PaulMargot/Casque-velo/Rapports seances Margot/Seance3/compte_rendu_seance3.odt

Compte rendu séance 3 :

Durant cette 3ème séance j'ai fait la partie programmation en rapport avec la photorésistance et le freinage. C'est-à-dire l'allumage du phare (LED verte) et du feu (LED rouge) lorsque la luminosité extérieure est trop faible, afin de rendre visible la route et l'utilisateur, et celui du feu lorsqu'on freine.

Ainsi j'ai complété mon programme « clignotants » en créant « LEDs_casque », regroupant les fonctionnalités liées à l'eclairage du casque, c'est-à-dire les clignotants, le phare et le feu.

L'allumage du feu se divise en deux parties. Une première partie est liée à la luminosité ambiante (''// Feu luminosite'' dans le programme) et une autre à l'accélération (''// Feu accelerometre''), qui détecte lorsque l'on freine afin d'allumer avec plus d'intensité notre feu.

Cette différence d'intensité sera normalement visible par l'allumage de plus nombreuses LEDs lors du freinage, suivant le même modèle que les feux de voiture.

De telle manière :

Nuit/Jour + freinage :

Nuit :

: LED éteinte

: LED allumée

Cependant, lorsque nous activons les clignotants et le feu stop simultanément, ce dernier ne fonctionne pas alors que les clignotants sont opérationnels. Je suppose alors que l'hc06 n'arrive pas à traiter tous les messages que l'hc05 lui envoie, il nous faudra donc régler ce problème lors de la prochaine séance.
