PaulMargot/Casque-velo/Rapports seances Margot/Seance2/Algo clignos.odt

Algorithme Clignotants :

Initialisation des led

en OUTPUT

Lecture du message

Si le

message est « e » :

Si le

message est « w » :

On éteint toutes les led

Si le

message est « g » :

Si le

message est « d » :

On allume toutes les led

On allume les led gauches

On allume les led droites
