PaulMargot/Casque-velo/Rapports seances Margot/Seance4/compte_rendu_seance4.pdf

### Compte rendu séance 4 :

Durant cette séance, nous avons réfélchi avec Paul à comment intégrer les LEDs sur le casque. Nous avions pensé à des bandes led que nous disposerions de la manière dessinée dans la vidéo « casque.MP4 ». Cependant après en avoir parlé avec Mr Masson, nous avons convenu qu'il serait mieux de créer un bandeau led pour l'arrière, représentant le feu et les clignonatnts et pour l'avant une simple bande led blanche pour être vu et une LED 3W pour voir tel que :

Casque vue avant : | Casque vue arrière frein+nuit :

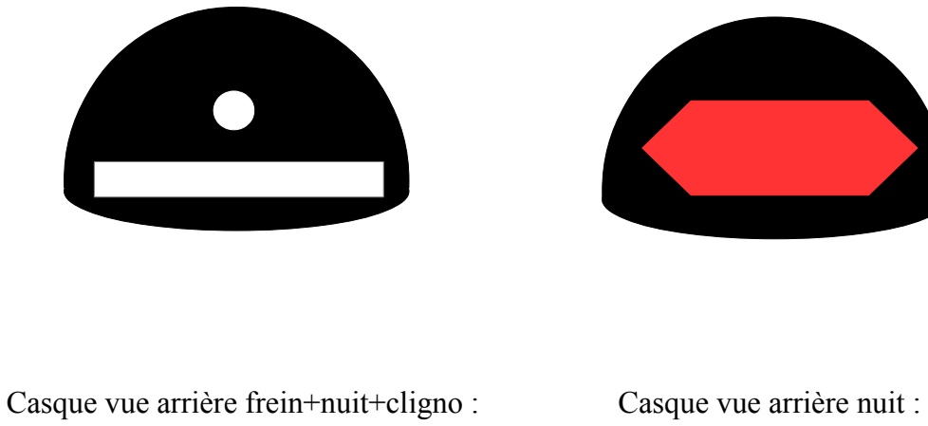
[picture p38: figure]
Casque vue arrière frein+nuit+cligno :; Casque vue arrière nuit :
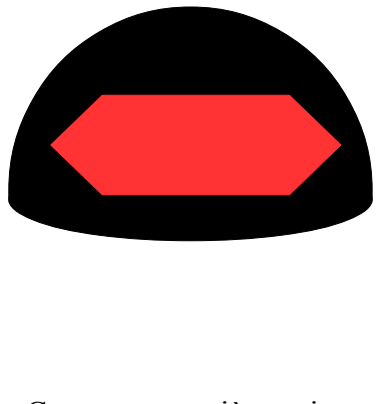
[picture p39: figure]
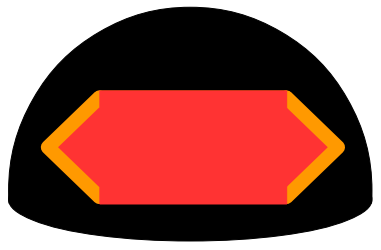
[picture p40: figure]
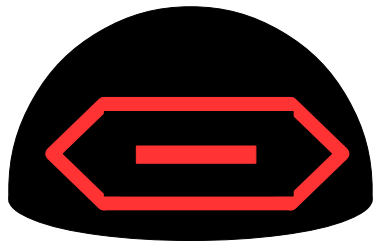
[picture p41: figure]

Pour cela nous avons dû télécharger une nouvelle librairie « NeoPixel » pour programmer la bande LED et inclure ''Adafruit_NeoPixel.h'' dans notre code.
Je me suis alors inspirée de «Test_10_LED_MEGA.ino» que Mr Masson m'a envoyé pour allumer toute la bande led en rouge dans un premier temps :

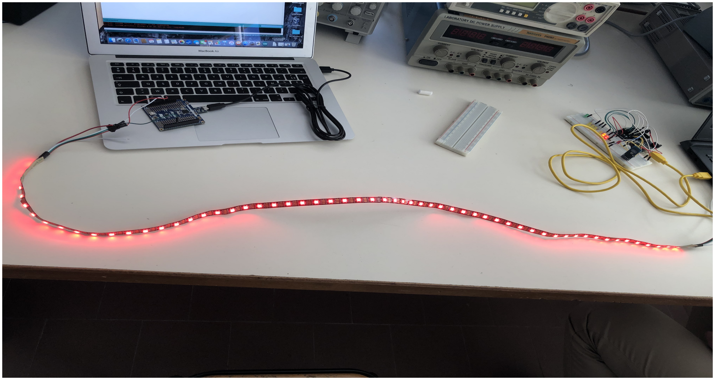
[picture p42: figure]

Puis j'ai fait une alternance de LEDs oranges et rouges pour representer nos clignotants gauche et droit ainsi qu'une partie du feu, le contour de notre bandeau arrière concrètement :

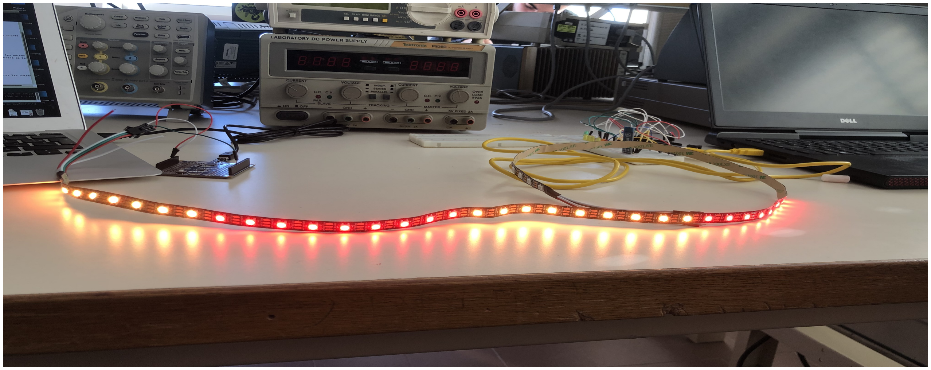
[picture p43: figure]

Lors de la prochaine séance nous essayerons d'allumer en différé les LEDs orange représentant les clignotants tel que :
