PaulMargot/Casque-velo/Rapports seances Paul/README.md

Répertoire contenant les rapports de séances de Paul MASSON
