PaulMargot/Casque-velo/Rapports seances Margot/Seance1/compte_rendu_1.odt

STRABACH Margot G1

Compte rendu séance 1 :

Lors de cette première séance nous avons fait le cahier des charges (CDC) chacun sur notre ordinateur, comprenant la présentation et le but de notre projet, ainsi qu'un «diagramme pieuvre» et les solutions techniques proposées pour remplir notre CDC.

Ensuite j'ai créé notre compte GitHub et fait l'état de l'art de notre casque de vélo intelligent qui a déjà été pensé et fabriqué, par les créateurs de la marque LUMOS notamment.

Enfin nous avons réussi à établir une connexion entre notre hc05 et hc06 grâce à nos deux ordinateurs et par le code contenu dans '' setup_hc ''. En effet, depuis le moniteur de série nous arrivons à envoyer des messages à celui de l'autre ordinateur ainsi qu'à en recevoir.

De plus, lors de la séance précédente, ayant fini le dernier TD en avance, nous avions commencer notre projet et j'avais soudé à l'étain des fils aux boutons pour nos clignotants afin de pouvoir les connecter à notre carte arduino.

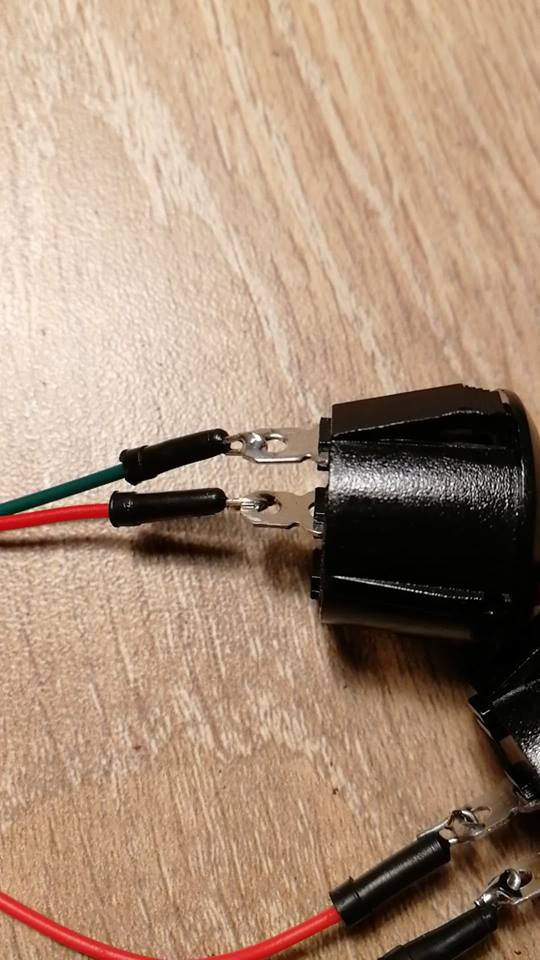
[picture p72: figure]
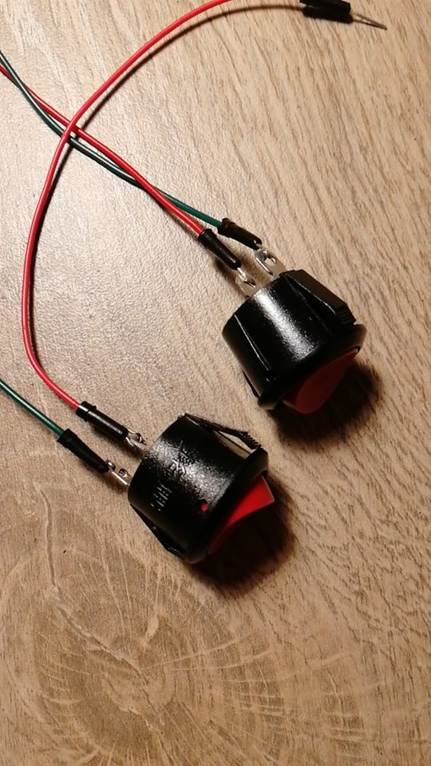
[picture p73: figure]
