PaulMargot/Casque-velo/PRESENTATION.pdf

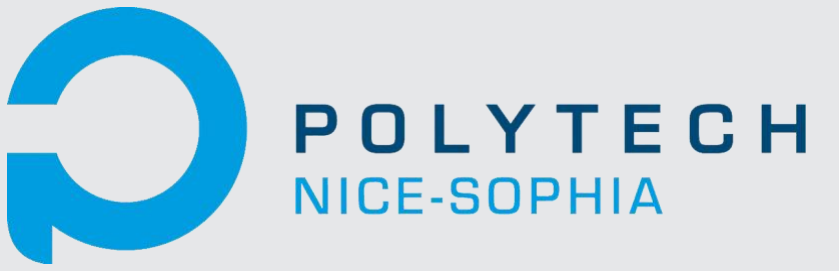
[picture p74: figure]

# Casque de Vélo Intelligent

STRABACH Margot & MASSON Paul

Projet d’Electronique

I N T R O D U C T I O N

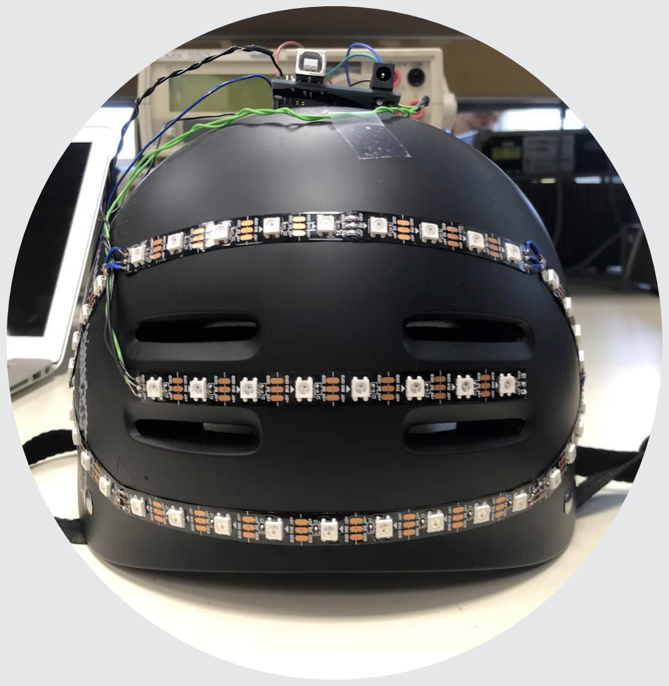
[picture p75: figure]

Comment améliorer la visibilité des cyclistes ?

Adaptation des équipements d’un véhicule motorisé à un casque de vélo

I N T R O D U C T I O N

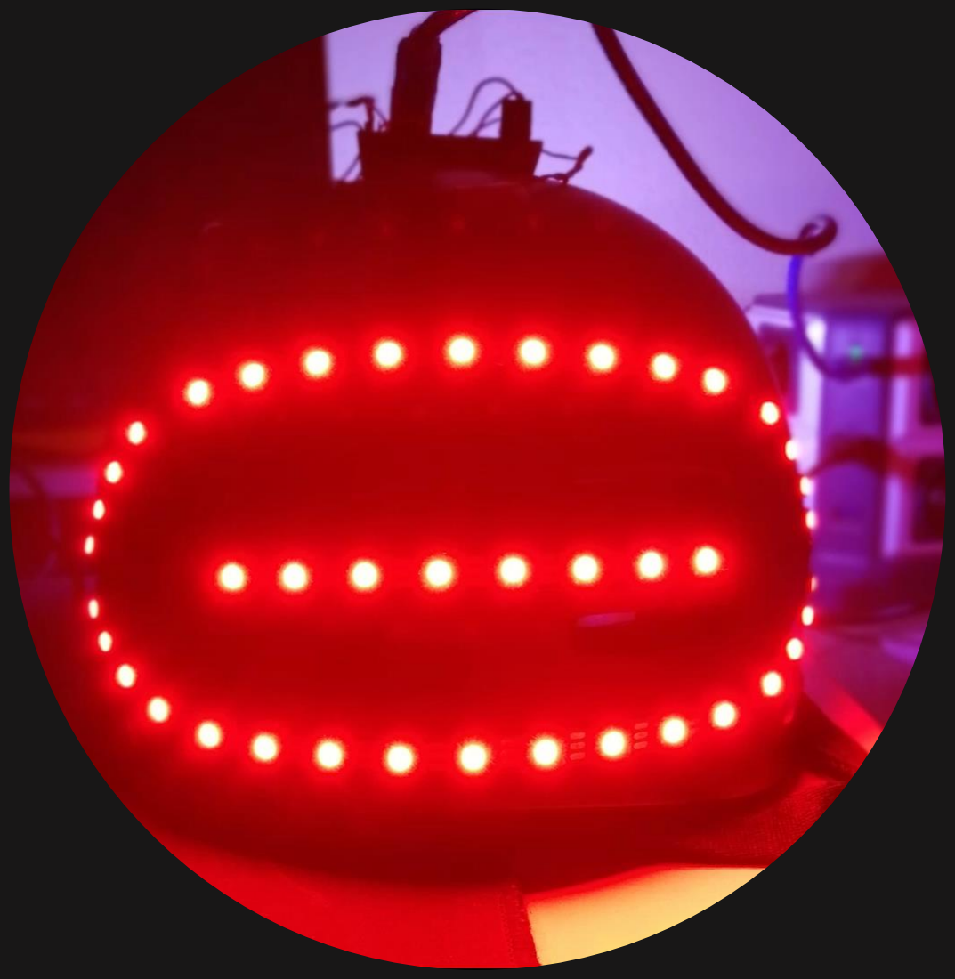
[picture p76: figure]

Comment améliorer la visibilité des cyclistes ?

Adaptation des équipements d’un véhicule motorisé à un casque de vélo

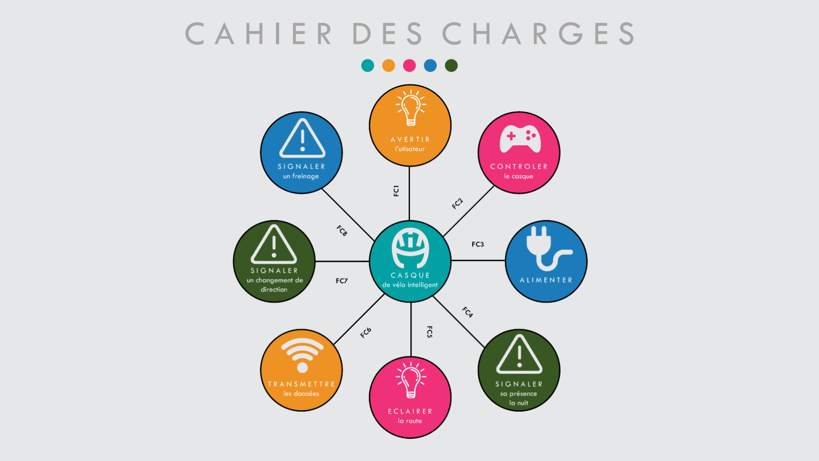
[picture p77: page 4]

C A H I E R D E S C H A R G E S

P L A N N I N G

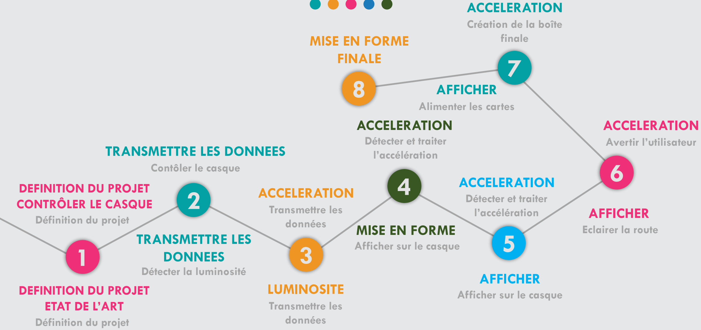
[picture p78: figure]
DEFINITION DU PROJET CONTRÔLER LE CASQUE; Définition du projet; TRANSMETTRE LES DONNEES; Contôler le casque; ACCELERATION; Transmettre les données; Détecter et traiter l’accélération; Avertir l’utilisateur; Détecter la luminosité; MISE EN FORME; Afficher sur le casque; AFFICHER; Eclairer la route; DEFINITION DU PROJET ETAT DE L’ART; LUMINOSITE; Création de la boîte; finale; FINALE; Alimenter les cartes

C O N T R Ô L E S D U C A S Q U E

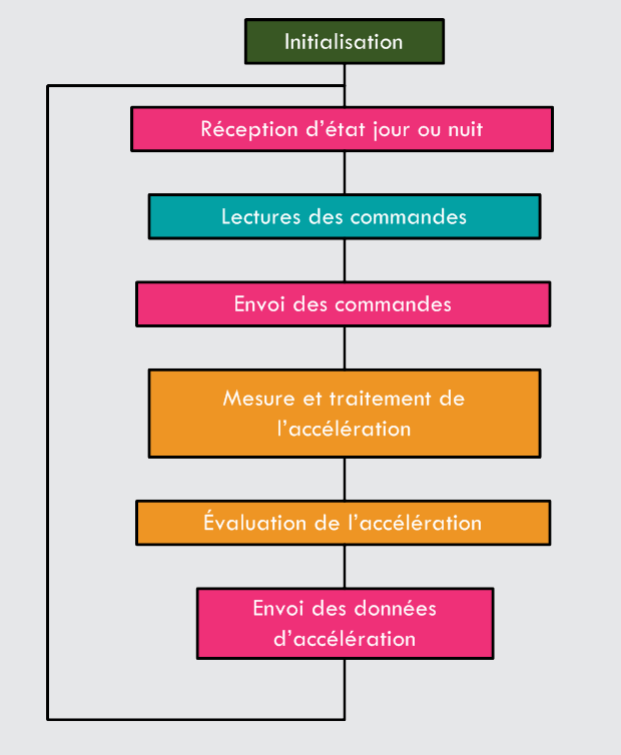
[picture p79: figure]

Contrôler

le casque

Transmettre

les données

Détecter & Traiter

l’accélération

Alerter

l’utilisateur

C O N T R Ô L E R

01
REPOND
aux besoins du
cahier des
charges

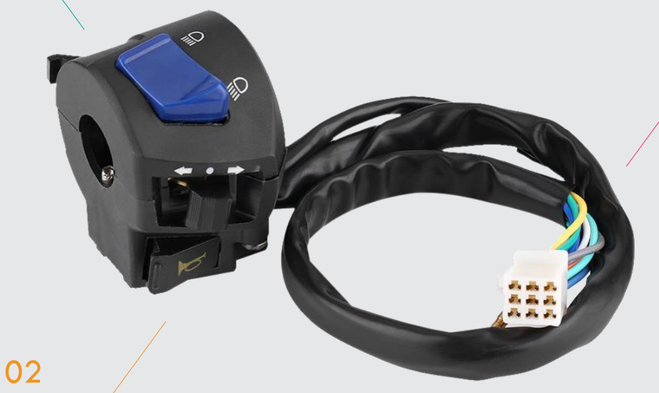
[picture p80: figure]

SIMPLIFIE
l’utilisation en
regroupant
toutes les
commandes

03
ATTACHABLE
au guidon du
vélo

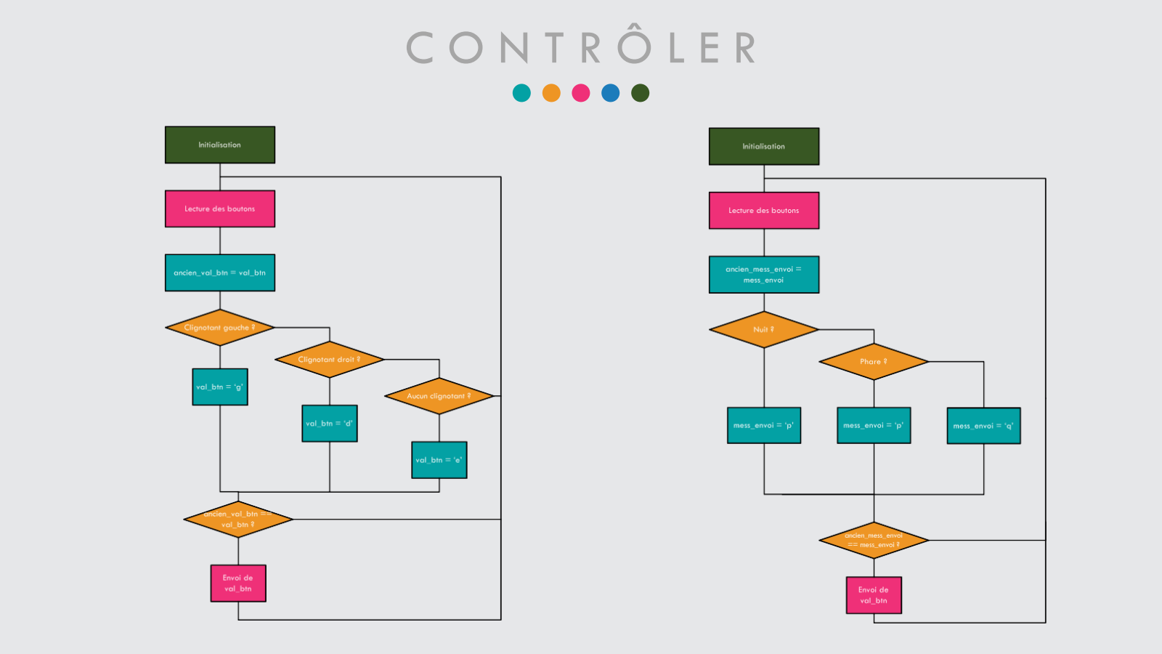
[picture p81: page 8]

C O N T R Ô L E R

S I G N A L E R U N F R E I N A G E

01
DETECTION
du freinage
automatique

02
GYROSCOPE
à 3 axes

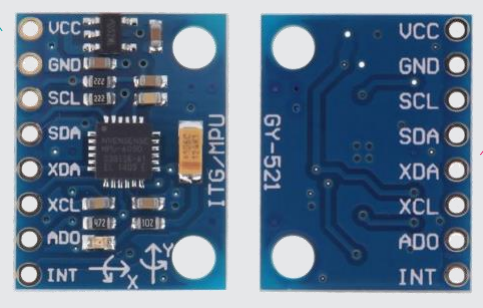
[picture p82: figure]
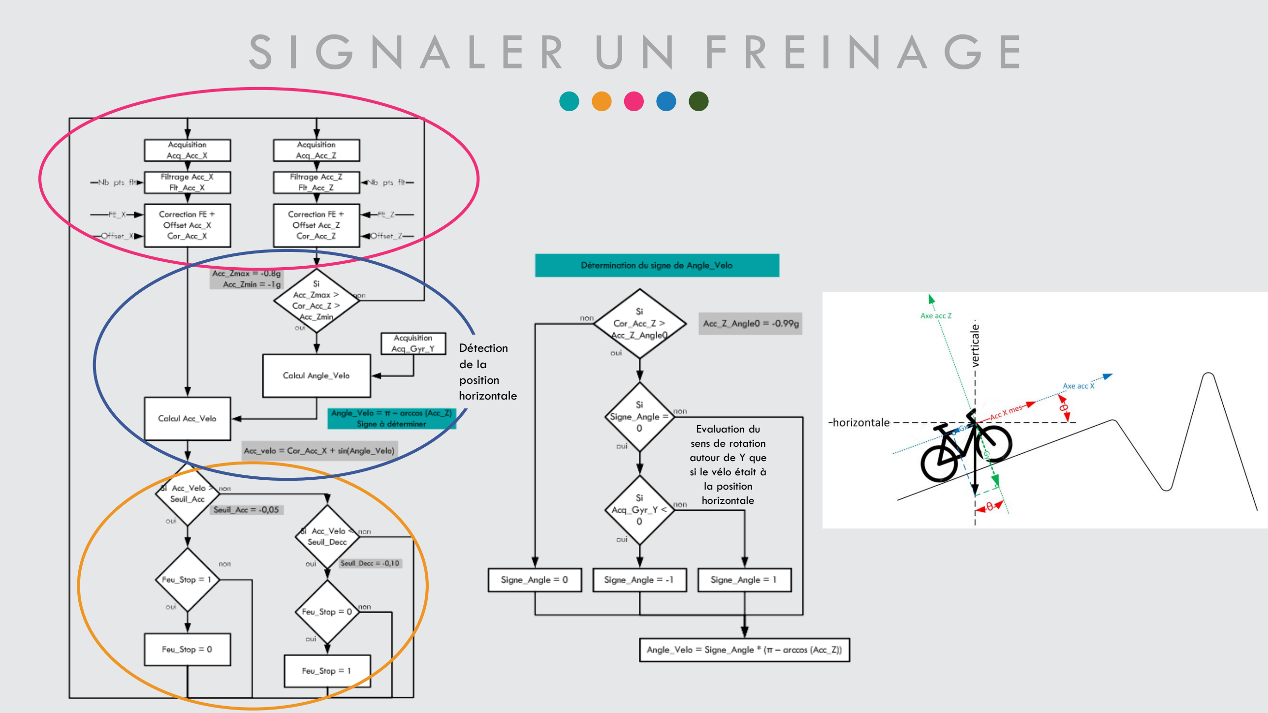
[picture p83: page 10]

S I G N A L E R U N F R E I N A G E

Détection
de la
position
horizontale

Evaluation du
sens de rotation
autour de Y que
si le vélo était à
la position
horizontale

T R A N S M E T T R E

01
COMMUNICATION

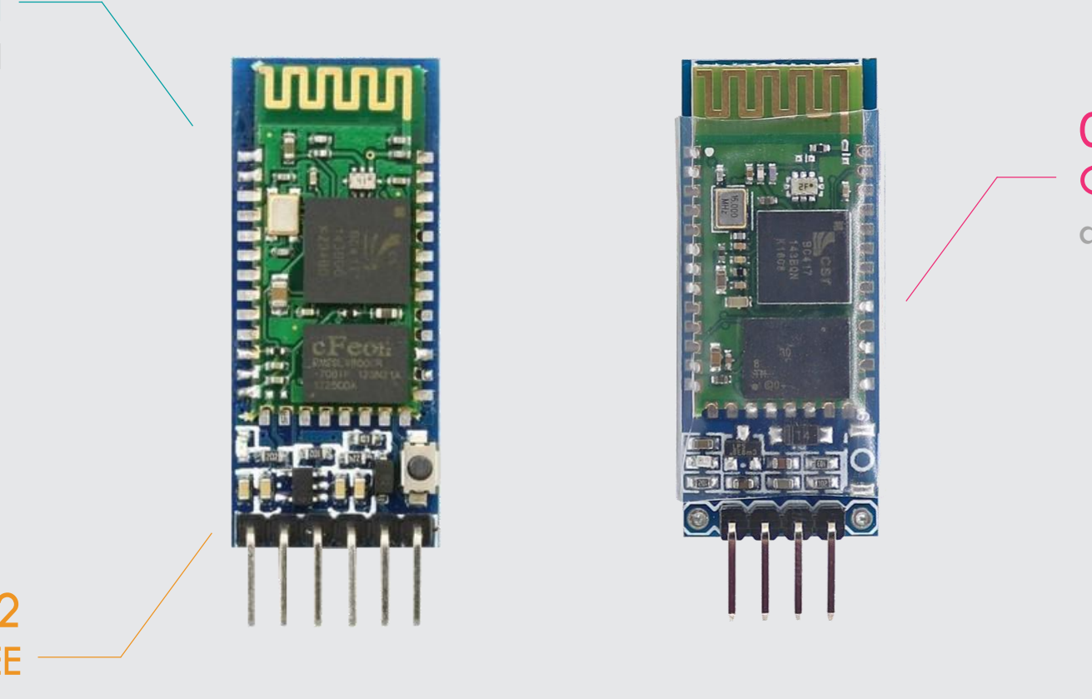
[picture p84: figure]

sans fil

02
PORTEE
suffisante

03
CONNECTION
automatique

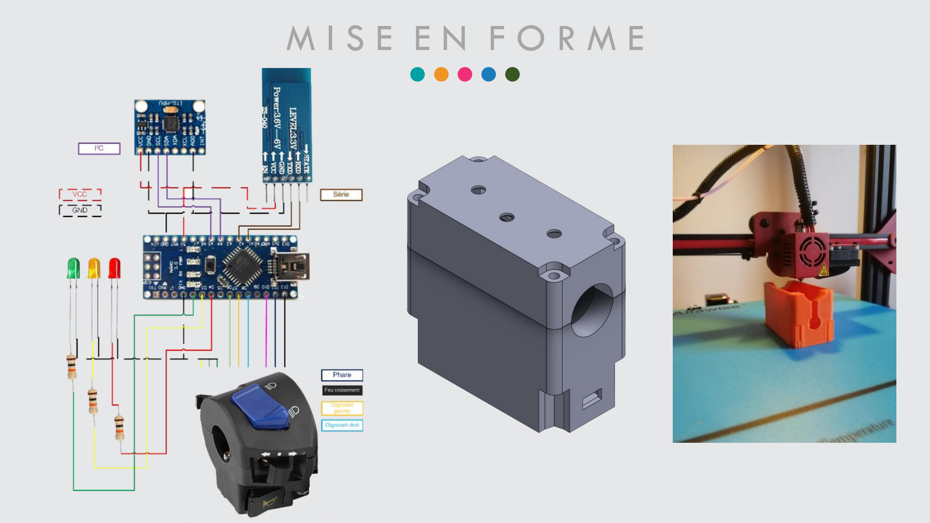
[picture p85: page 12]

M I S E E N F O R M E

C A S Q U E

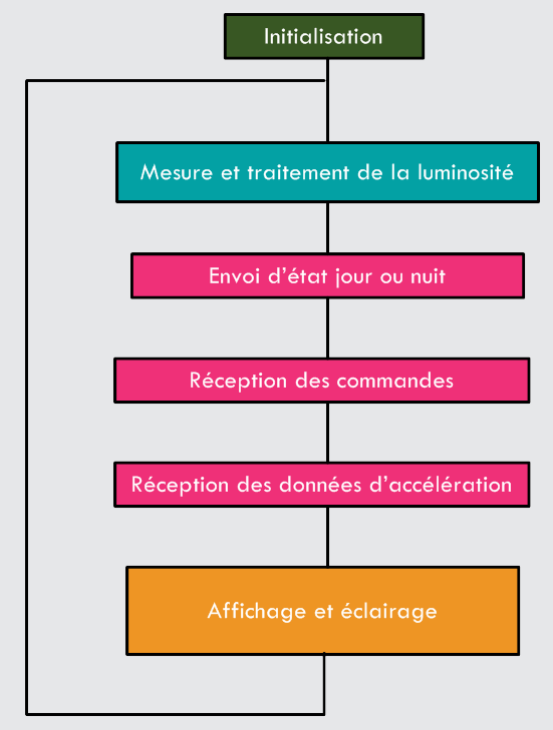
[picture p86: figure]

Signaler

sa présence la nuit

Signaler

Un changement de direction

Signaler

un freinage

Eclairer

la route

S I G N A L E R S A P R E S E N C E L A N U I T

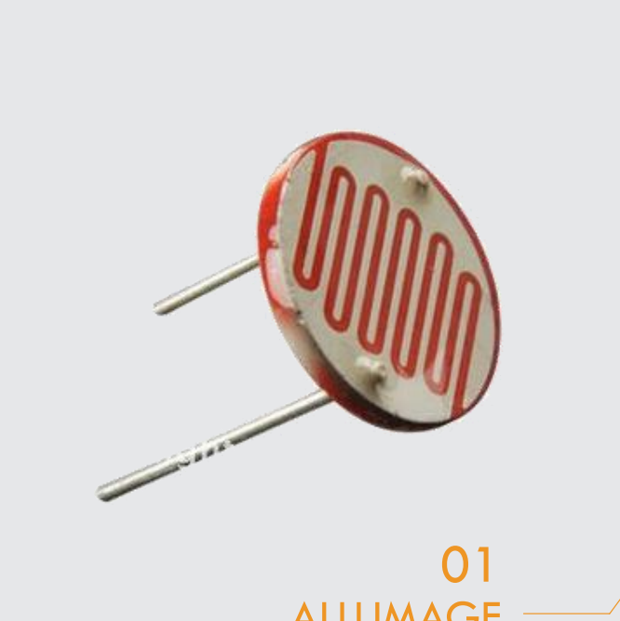
[picture p87: figure]

ALLUMAGE
des LEDs
indépendant

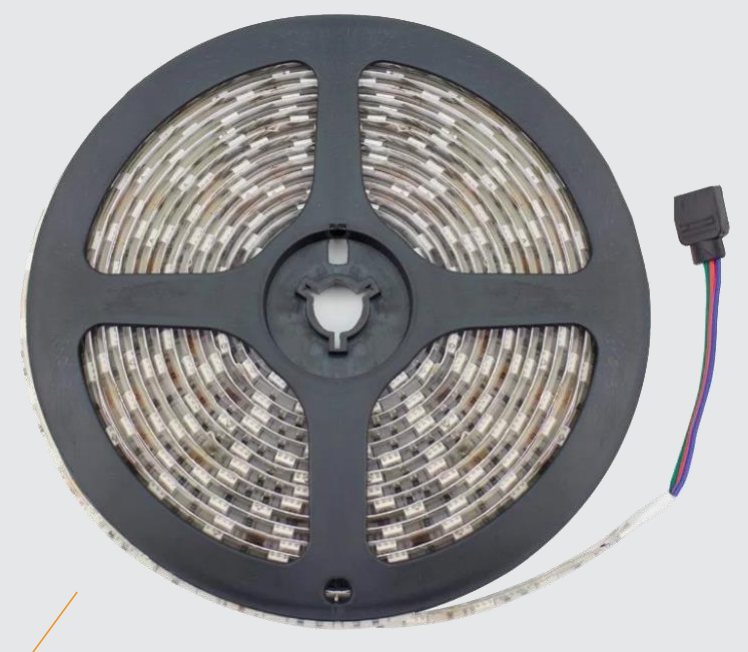
[picture p88: figure]

02
FACILEMENT
intégrable au
casque

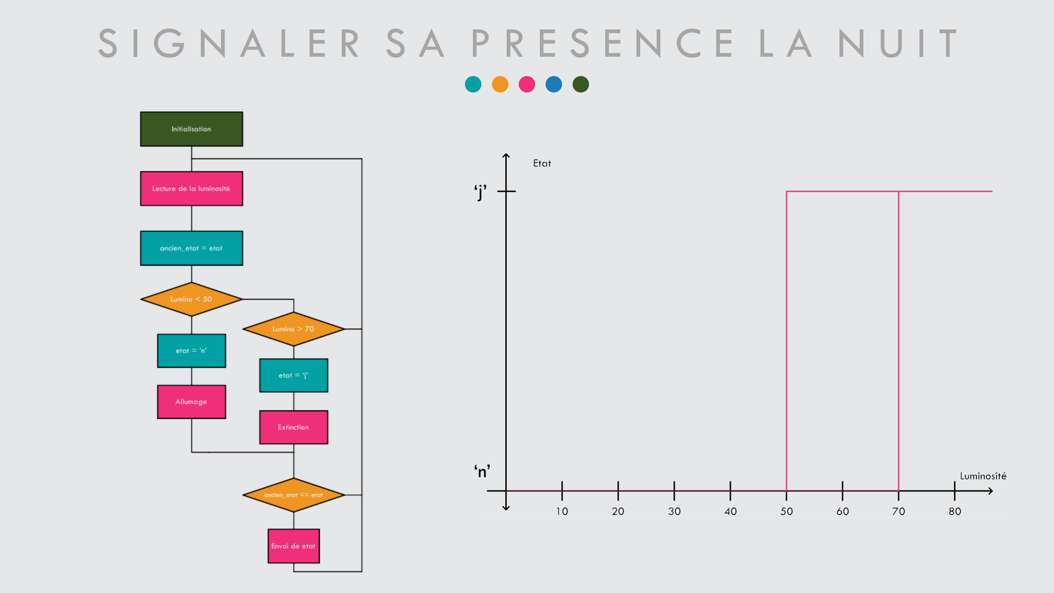
[picture p89: page 15]

S I G N A L E R S A P R E S E N C E L A N U I T

‘j’

‘n’

E C L A I R E R L A R O U T E

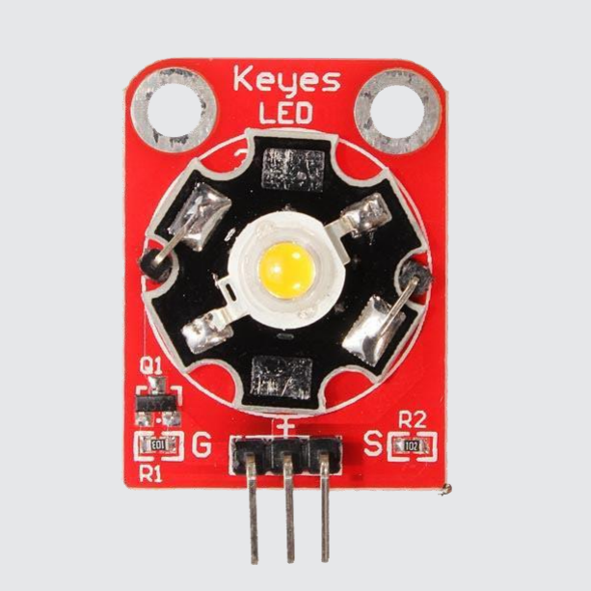
[picture p90: figure]
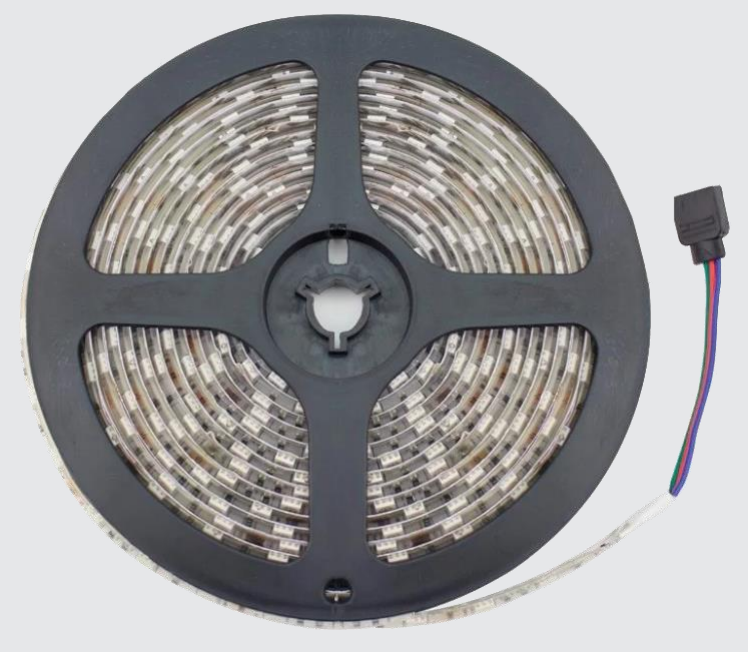
[picture p91: figure]
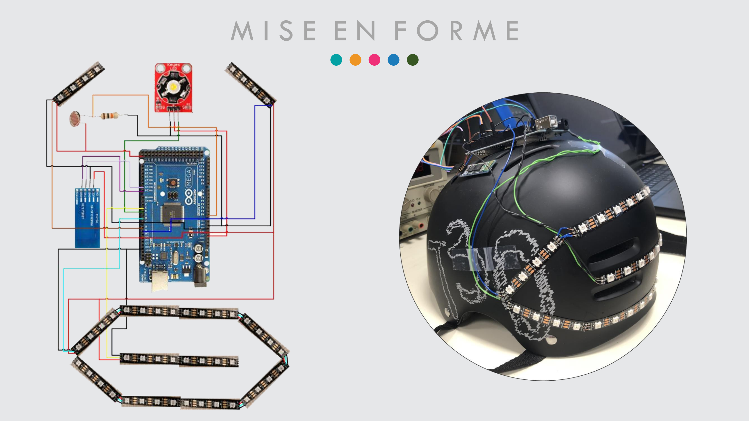
[picture p92: page 17]

M I S E E N F O R M E

P R O B L E M E S R E N C O N T R E S

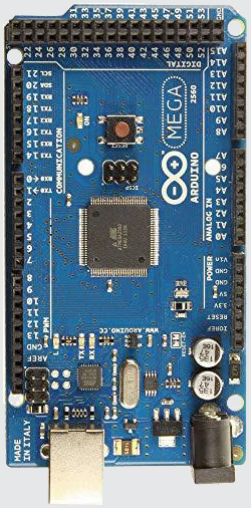
[picture p93: figure]
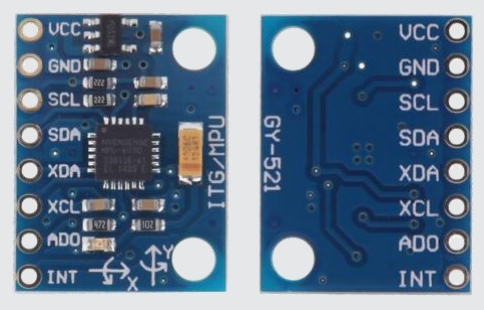
[picture p94: figure]
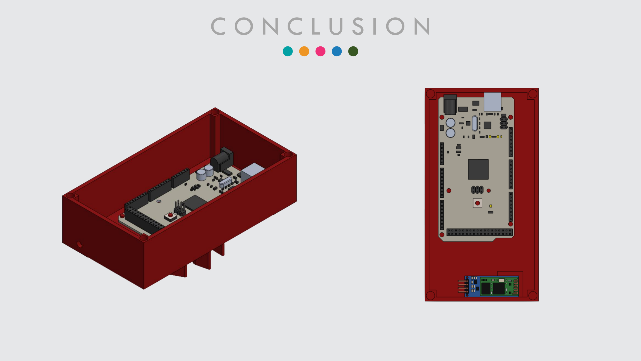
[picture p95: page 19]

C O N C L U S I O N
