PaulMargot/Casque-velo/Rapports seances Paul/Boite finale/Boite_partie1.SLDPRT

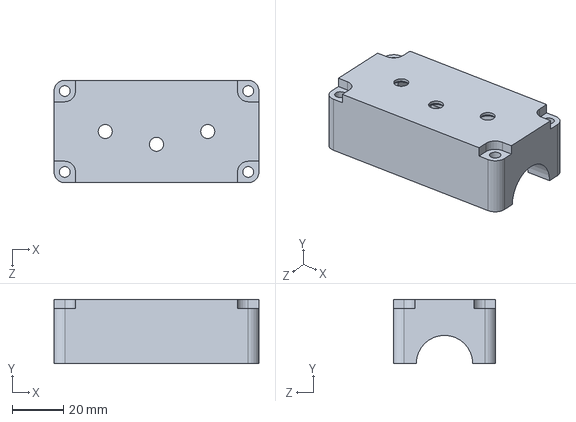
[picture p96: CAD file, 2019-02-11]
Rapports seances Paul/Boite finale/Boite_partie1.SLDPRT
80.0 x 25.0 x 40.0 mm
