PaulMargot/Casque-velo/Rapports seances Paul/Boite/Boite1.SLDPRT

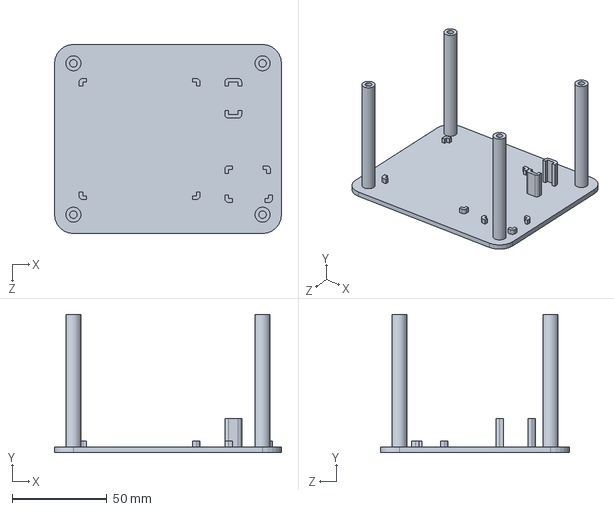
[picture p97: CAD file, 2019-01-07]
Rapports seances Paul/Boite/Boite1.SLDPRT
120.0 x 73.0 x 100.0 mm
