PaulMargot/Casque-velo/Rapports seances Paul/Boite finale/Boite_partie2.SLDPRT

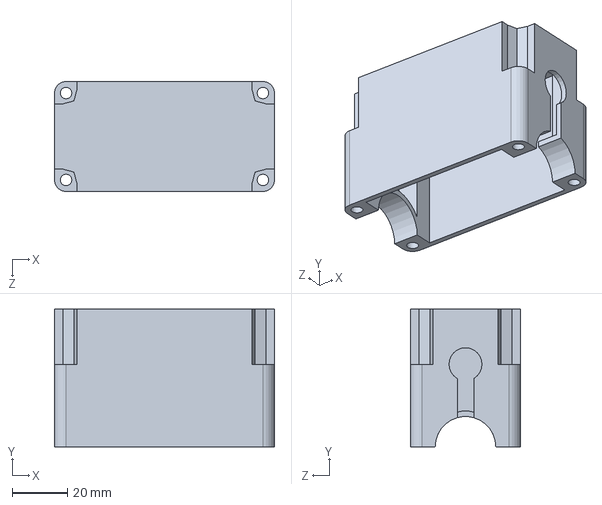
[picture p98: CAD file, 2019-02-11]
Rapports seances Paul/Boite finale/Boite_partie2.SLDPRT
80.0 x 50.0 x 40.0 mm
