PaulMargot/Casque-velo/Rapports seances Paul/Boite/Boite2.SLDPRT

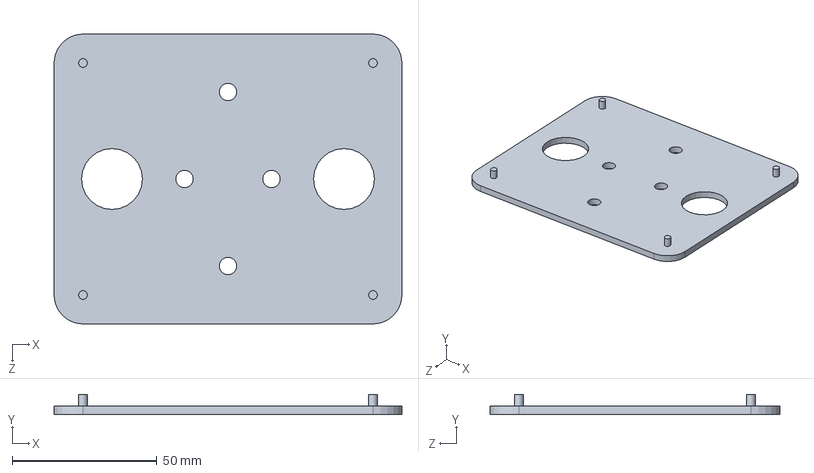
[picture p99: CAD file, 2019-01-07]
Rapports seances Paul/Boite/Boite2.SLDPRT
120.0 x 7.00 x 100.0 mm
